guchemin/Scanner-3D/(list of files, cad)

Other CAD files:
nuvem_de_pontos_final.ply
